samay312006/cad_project/docs/review/fig_serial_monitor.png

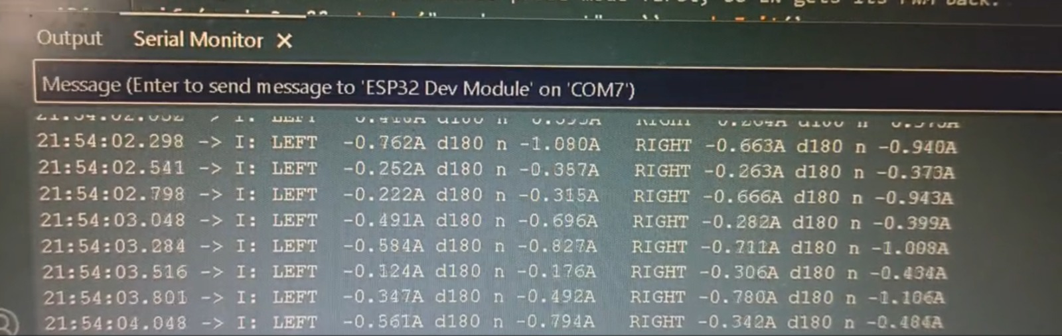
docs/review/fig_serial_monitor.png
