samay312006/cad_project/docs/review/fig_bench_photo.png

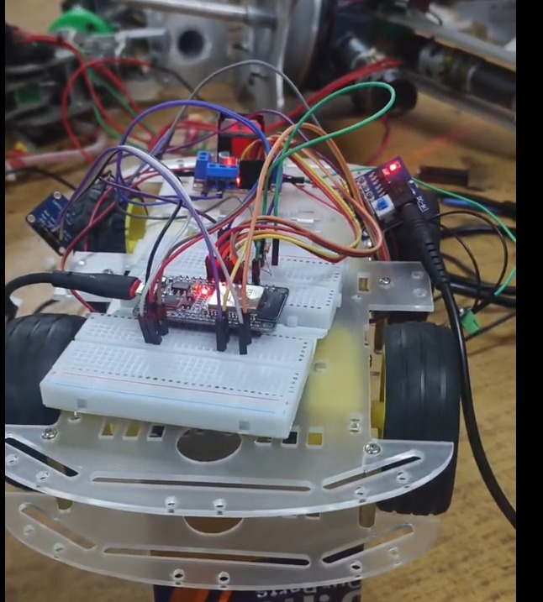
docs/review/fig_bench_photo.png
