samay312006/cad_project/UPDATES.md

# Updates & Blockers

Read this at the start of every session, both engineers. It's a pointer list, not a
discussion log — details belong in `spec.md`/`plan.md` or your own commits/PRs.

## Open blockers

| # | Blocker | Blocks | Owner to resolve | Opened |
|---|---|---|---|---|
| 3 | Single-point range sensor + servo BOM (`[TBD]` in spec) not chosen — sensor sample time and servo slew speed are unknown, so achievable scan rate/resolution is unknown | Both — embedded can't finalize driver/timing code; cloud/GUI can't set realistic SLAM Toolbox scan-rate expectations or Follow-me acceptance criteria (`spec.md` §8 Follow-me/SLAM rows are explicitly left open pending this) | Human (BOM decision) | 2026-08-27 |
| 6 | Incline-compensation telemetry fields (`spec.md` §6.1) — the approved design adds `boost_pct` (float, 0.0–0.5) and `compensating` (bool) to the telemetry message so the GUI can indicate when the ESP32 is boosting drive power. Design approved but **not yet written into §6.1**; fields do not exist on the wire yet | Cloud/GUI engineer — don't bind a dashboard to the current §6.1 shape without accounting for these two additive fields. Additive only, nothing renamed or removed | Embedded engineer (to land the §6.1 edit) | 2026-09-03 |
| 9 | **Partly done 2026-10-17 on the real EC2 link** (details in `HANDOFF.md` top note): connect, drive, telemetry, watchdog (fires 1.5 s after last received message; ~2.4-2.9 s end-to-end because link latency ~1 s), inbound-black-hole stop (~2 s, not 15 s), and broker-restart auto-reconnect (~2 s) all pass. **Still needs the human at the bench:** Wi-Fi drop + auto-reconnect, telemetry cross-check vs `drive_test.ino` under load, human-observed motor direction. Original text: New MQTT-based `embedded/web_drive/` firmware + `cloud/dashboard/` frontend (`docs/superpowers/plans/2026-10-04-cloud-web-dashboard.md`) is written and passes local-rehearsal checks against a Dockerized Mosquitto broker, but **has not been bench-tested on real ESP32 hardware** — same situation as the original web_drive bring-up tool (`UPDATES.md` #7's resolution). Needs: wheels-off-the-ground bring-up, watchdog-trip verification on a real link **including a mid-packet/partial-drive-message link drop specifically** (`mqtt_handler.h`'s `setSocketTimeout(1)` bounds but doesn't eliminate a `PubSubClient::loop()` blocking stall — confirm the watchdog still fires within ~2.5s, not the library's old 15s default), a check that the ESP32 core's default Wi-Fi auto-reconnect actually recovers the link without a manual reset, and telemetry cross-check against `drive_test.ino`'s known-good values (full checklist in the design doc's §8 and the plan's Task 4 Step 4). | Whoever's at the bench next — hardware bring-up isn't role-exclusive the way firmware authorship is (see `ONBOARDING.md` §1's physical-hardware note) | Whoever does the bench bring-up | 2026-10-06 |
| 10 | Dropping the phone bridge means the ESP32 itself (not the phone) now needs internet reachability for the full robot, and the ESP32 has no cellular radio in the current sensor list (`spec.md` §4, `ESP32 variant` still `[TBD]`) — outdoor/away-from-fixed-Wi-Fi operation needs either a carried Wi-Fi hotspot or a cellular-capable ESP32 variant/add-on, neither currently planned (`spec.md` §7 assumption 6, `plan.md` §2c.2). | Both — affects the embedded engineer's eventual ESP32-variant BOM choice and the cloud/GUI engineer's assumptions about field connectivity | Human (BOM/connectivity decision, same category as blocker #3) | 2026-10-06 |
| 11 | The MQTT-based redesign has no per-topic client arbitration — the old local-AP design allowed at most one WebSocket client at a time (`wsClientFd`); `robot/{id}/drive` now accepts publishes from any connected client with no "who's in control" concept, so two open dashboard tabs/devices would silently fight over the same topic. Not fixed by `docs/superpowers/plans/2026-10-04-cloud-web-dashboard.md` (out of its v1 scope, design D7) — flagging so it isn't a silent regression. | Cloud/GUI engineer, whenever multi-operator/multi-tab use becomes a real scenario (not v1) | Cloud/GUI engineer | 2026-10-06 |
| 12 | `plan.md` §2a's local-sim architecture (§2a.2/2a.3/2a.5/2a.6 — the Gazebo "simulated-phone" ROS2 node) still describes the old ESP32↔phone JSON-over-UDP contract and wasn't updated by `docs/superpowers/plans/2026-10-04-cloud-web-dashboard.md` (out of that plan's scope — it only touched `plan.md` §2c). Needs its own pass once SLAM/Nav2 sim work actually starts. | Cloud/GUI engineer (2a is cloud/GUI-owned sim work) | Cloud/GUI engineer | 2026-10-06 |
| 13 | `CLAUDE.md`, `ONBOARDING.md`, and the `CLAUDE.local.md` template in `ONBOARDING.md` still describe the cloud/GUI role as owning "the Android phone app (GUI + phone-side Wi-Fi client + phone-side MQTT client)" and the shared-contract line still says "the ESP32↔phone message schema and the phone↔EC2 MQTT topics" — both stale after blocker #8's resolution. Nobody's `CLAUDE.local.md` has been updated to mention `cloud/dashboard/` or who owns `embedded/web_drive/mqtt_handler.h` going forward. Not fixed here — these are shared project-instruction files and changing the stated role boundary is a human decision, not something either engineer's session should do unilaterally. | Both sessions read these at the start of every session — stale role text risks the next cloud/GUI session either building the cancelled Android app or being unsure whether it still owns `embedded/web_drive/mqtt_handler.h` | Human (role-boundary wording decision) | 2026-10-06 |
| 14 | `spec.md` §5's mode-transition table and §6.1's Fail-safe bullet both now mark "ESP32↔EC2 heartbeat loss → SAFE_HOLD" as `[TBD]` (see the note added under §5's table 2026-10-06) — the old design had two separate links with two separate fail-safe policies (ESP32↔Phone heartbeat loss → SAFE_HOLD; Phone↔EC2 loss → degrade-but-continue, NFR-6), and collapsing them into one ESP32↔EC2 hop left it undefined which policy a *total* link loss should trigger, versus NFR-6's narrower "stale plan" case. The `heartbeat` `cmd_type` itself has no defined rate/timeout either. | Embedded engineer — needs this resolved before building SAFE_HOLD/the mode state machine on the ESP32, since it changes what `mqtt_handler.h` needs to do beyond the drive watchdog | Embedded engineer (with cloud/GUI, since it also affects what the dashboard needs to show) | 2026-10-06 |
| 15 | **EC2 broker is up (2026-10-16)** in `ap-southeast-2`, account 687633314412 (profile `robot2`): `robot-broker-2` (`i-076e0f36edc586e82`, t3.small) at Elastic IP `52.65.238.172`; Mosquitto TLS 8883 (self-signed cert, IP SAN) + nginx 443 serving the dashboard with `/mqtt` WSS proxy; users `esp32` and `dashboard` (passwords only in the human's `~/.robot-broker-credentials`, not in git). Config in `cloud/ec2/`. SSH (22) is open to 0.0.0.0/0 at the human's request, key `~/.ssh/robot-broker-2.pem`. Dashboard `wss://` + login overlay is **done and deployed** (2026-10-16; https = login + `wss://host/mqtt`, plain http = local anonymous rehearsal unchanged). **ESP32 flashed 2026-10-17** and running the TLS firmware (pinned cert + `esp32` login). The TLS change is now **in the repo** (`embedded/web_drive/mqtt_handler.h`, `web_drive.ino`; one-off exception per `HANDOFF.md` §5, human-directed) — the embedded engineer owns these files again from here; credentials come from the gitignored `secrets.h` (template `secrets.h.example`). Bench results are in #9. **Open:** ~1 s link latency to Sydney (TCP connect ~0.43 s from the dev PC) — a Mumbai `ap-south-1` broker would likely help, needs the human's yes; $10/month budget alarm still needs an email from the human; old unused key pair `robot-broker` and SG `robot-broker-sg` remain (free) in Sydney. Formerly pending: the firmware TLS change (`mqtt_handler.h`: `WiFiClientSecure`, creds, trust the self-signed cert). Bench results/gotchas in `HANDOFF.md` (its 'no AWS resource exists' text is now stale) | ESP32 cannot reach the EC2 broker until the TLS change lands | Cloud/GUI (dashboard) / Embedded (firmware TLS) | 2026-10-13 |
| 16 | **Motors feel slow at full dashboard command.** Measured 2026-10-17 over the live link: a 255 command is applied as duty **131/255** (both sides, ~0.2-0.6 A, no load) because `drive_core.h` `dutyMaxCounts()` clamps to `V_MOTOR_MAX=5.5 V` using the *default, never-measured* `v0Drop=1.9 V`/`rTot=2.5` (motors rated 3-6 V on a 12.6 V L298N supply). Dashboard side already compensated (speed cap default 100%, `MIN_DUTY=70` floor in `mix.js`); the remaining limit is the firmware clamp, which cloud/GUI did not touch. Needs: run `drive_calib.ino` to measure the real drop, confirm motor voltage rating, decide whether to raise `V_MOTOR_MAX` (6.0 V rated max = ~143 duty, only ~9% more) or change motors/gearing | Embedded engineer (owns the clamp) / Human (motor rating, hardware) | Embedded engineer + Human | 2026-10-17 |
| 17 | **Human-directed changes 2026-10-17 (cloud/GUI session touched embedded files — logged here per CLAUDE.md):** (a) `embedded/web_drive/drive_core.h`: motor-voltage duty clamp **disabled** via `APPLY_MOTOR_VOLTAGE_CLAMP=false` (turns stalled at the clamped ~131/255) — with it off a full command puts ~10 V on 3-6 V motors, so the embedded engineer should decide the permanent policy (row #16); dashboard speed-cap slider removed. (b) New electromagnet support in `web_drive`: `magnet.h` (relay on **GPIO23** per the human — `drive_test.ino` and the team pin plan still say GPIO19, embedded engineer to reconcile), topic `robot/{id}/magnet` `{"on":bool}`, additive telemetry `magnet` field, state latched against watchdog/stop/link-loss — **new shared wire contract, `spec.md` §6.1 updated**. Not yet verified with a real relay/magnet attached | Embedded engineer: review/own these files going forward; dashboard binds to `magnet` in telemetry | Embedded engineer + Human | 2026-10-17 |

## Recently resolved

| # | Blocker | Resolution | Date |
|---|---|---|---|
| 5 | Current-sensor granularity (`spec.md` §4/§6.1) left `fl/fr/rl/rr` in the telemetry schema ambiguous about whether all 4 were independent readings | Resolved to 2x INA219, one per drive channel (left/right side, matching the skid-steer chassis) — `fl`==`rl` (left side) and `fr`==`rr` (right side) always report the same value. `spec.md` §4 (current sensor row) and §6.1 (telemetry example) updated with an explicit note. **Correction 2026-08-29**: an earlier version of this note/edit had the pairing backwards (`fl`==`fr`, front/rear) — fixed to the correct side-based pairing before it reached the diagram or any GUI work. If any GUI/dashboard work already assumed `fl`==`fr`, rebuild against the corrected schema. | 2026-08-29 |
| 1 | Wireless-link + sensor architecture wasn't yet applied to the docs | Applied to `spec.md` (§3, §4, §5, §6.1, §6.2, §6.3, §7, §8, §9), `plan.md` (2a.2, 2a.3, 2a.5, 2a.6, 2b.2, 2c.3, 2c.5), and both `overview_*.md` files. Both engineers can now code against the new interface. | 2026-08-27 |
| 2 | Packet framing for the ESP32↔phone Wi-Fi link wasn't defined | Defined in `spec.md` §6.1: UDP, one JSON message per datagram, `~1200 byte` MTU headroom, new `scan_sample` message type alongside existing telemetry/command messages. Still `[ASSUMPTION]`-tagged, not yet bench-verified, but the cloud/GUI engineer can build the phone-side client against it now. | 2026-08-27 |
| 4 | MQTT broker TLS/auth credential format for EC2 (`plan.md` 2b.3) not yet defined | Defined and live 2026-10-17: Mosquitto on 8883 with TLS (self-signed cert, CN/SAN = Elastic IP, pinned by the ESP32), username/password auth, two users `esp32` and `dashboard`, `/etc/mosquitto/acl` gives both `readwrite robot/#` (coarse; tighten per-topic later). Config in `cloud/ec2/`. | 2026-10-17 |
| 8 | Architecture change: `spec.md` §6.1/§6.2 (ESP32↔Phone↔EC2 two-hop) replaced by direct ESP32↔EC2 MQTT/TLS; phone-bridge role and the planned Android app are cancelled, replaced by a browser dashboard hosted on EC2. | User approved all of design decisions D1–D7 on 2026-10-04 (`docs/superpowers/specs/2026-10-04-cloud-web-dashboard-design.md`). Implemented locally only (no AWS resource created) per `docs/superpowers/plans/2026-10-04-cloud-web-dashboard.md`: `embedded/web_drive/` ported to Wi-Fi-station+MQTT (this session, explicit one-off exception — see that plan's role-boundary note), `cloud/dashboard/` is the new MQTT-over-WebSocket frontend, `cloud/docker-compose.yml` is the local Mosquitto rehearsal stack. `spec.md`, `overview_cloud.md`, `overview_controls.md`, and `plan.md` §2c updated to match. | 2026-10-06 |

## How to use this file

- Add a row the moment your work creates a dependency the other engineer needs to know
  about — don't wait for them to ask.
- When a blocker clears, move it to "Recently resolved" with a one-line note on how, and
  the date.
- Keep entries short. If it needs more than 2-3 sentences, put the detail in `spec.md` or
  a PR description and link to it here.
