samay312006/cad_project/docs/review/fig_current_plot.png

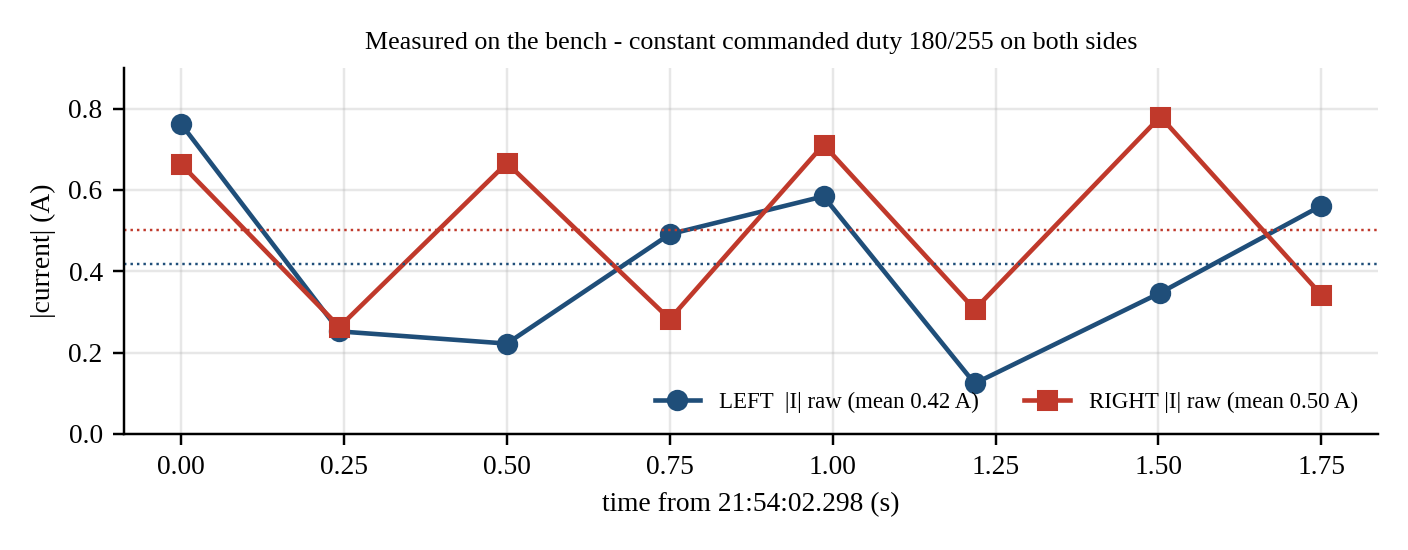
docs/review/fig_current_plot.png
