samay312006/cad_project/docs/review/fig_dash_login.png

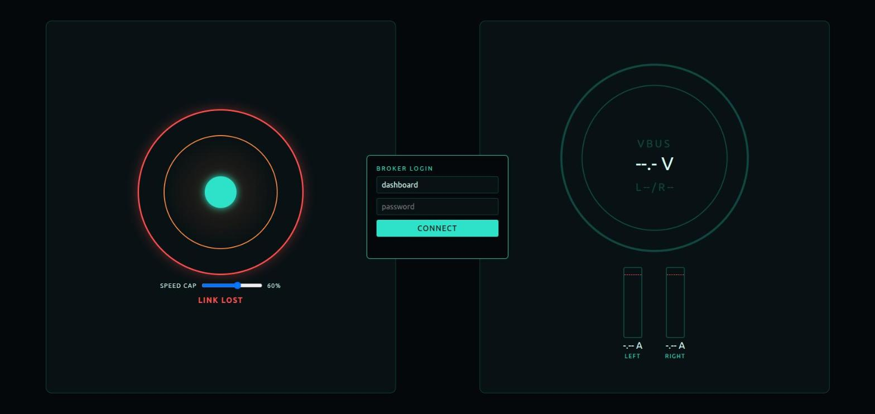
docs/review/fig_dash_login.png
