samay312006/cad_project/docs/review/fig_phone_live.png

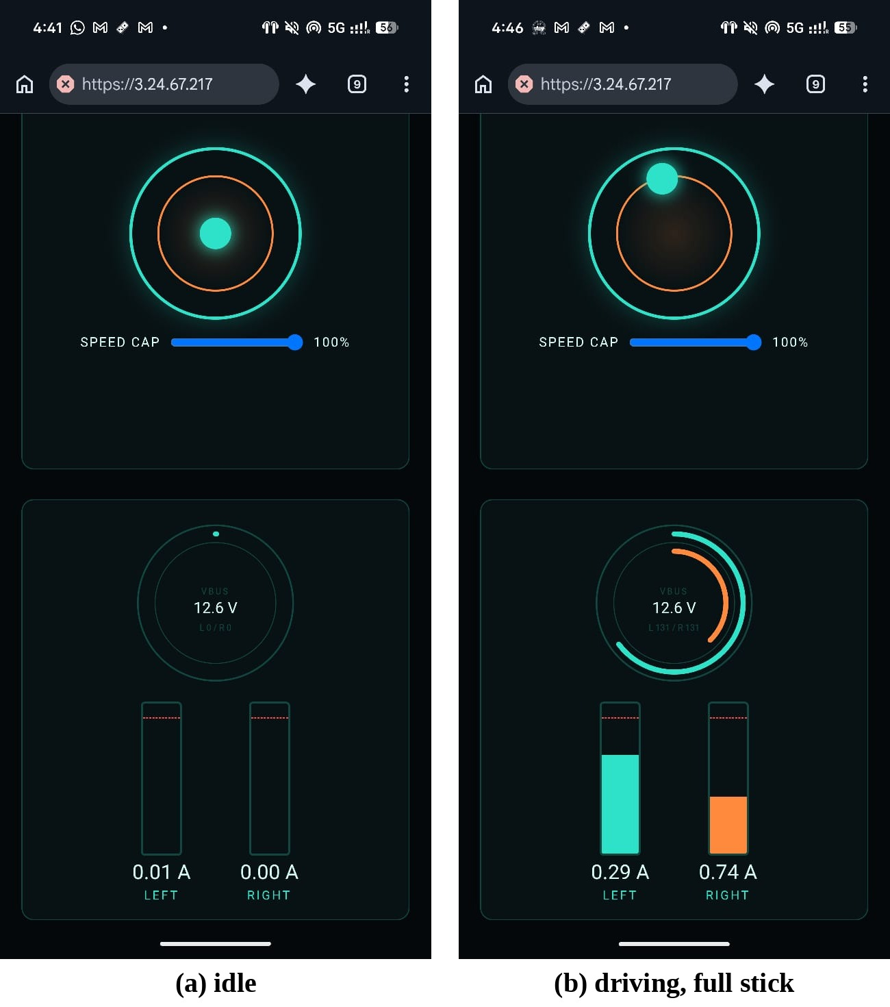
docs/review/fig_phone_live.png
