samay312006/cad_project/docs/review/fig_timings.png

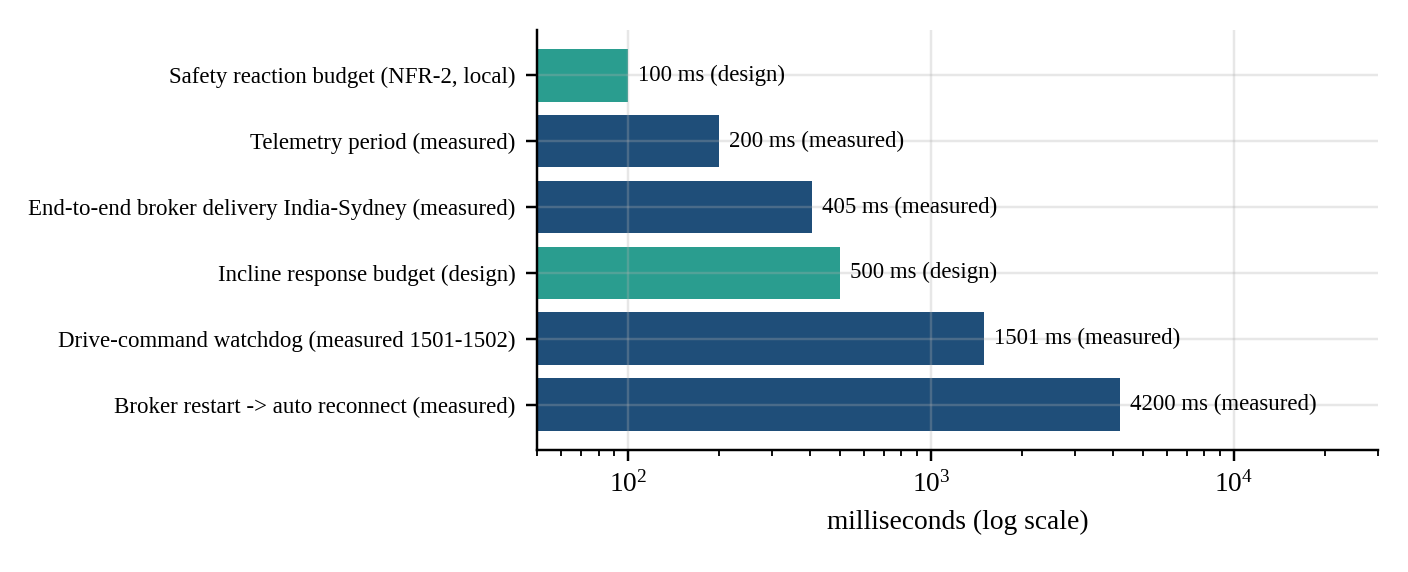
docs/review/fig_timings.png
