samay312006/cad_project/docs/review/fig_watchdog_plot.png

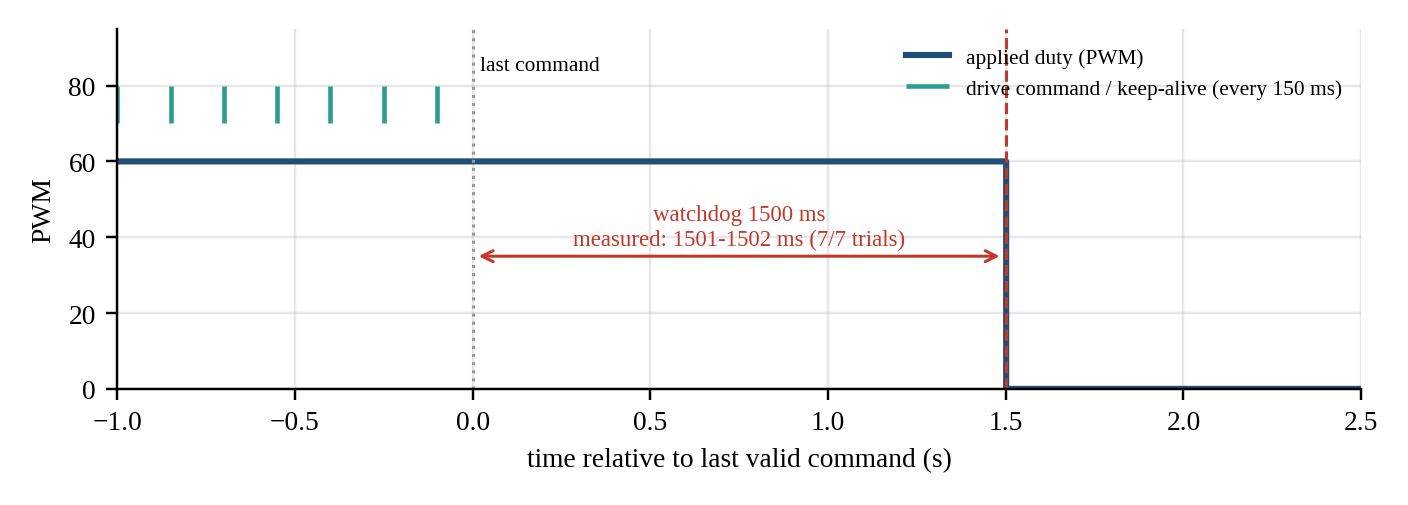
docs/review/fig_watchdog_plot.png
