samay312006/cad_project/docs/review/pin_actuators.png

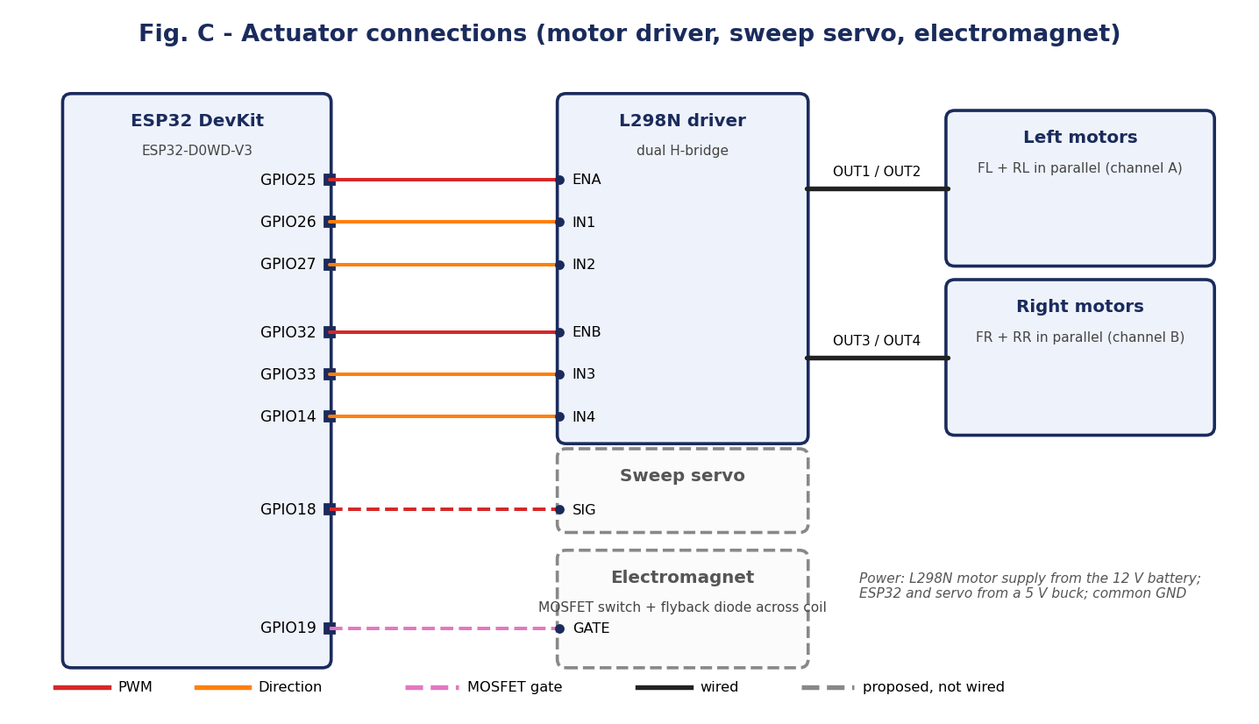
docs/review/pin_actuators.png
