samay312006/cad_project/docs/review/pin_gps.png

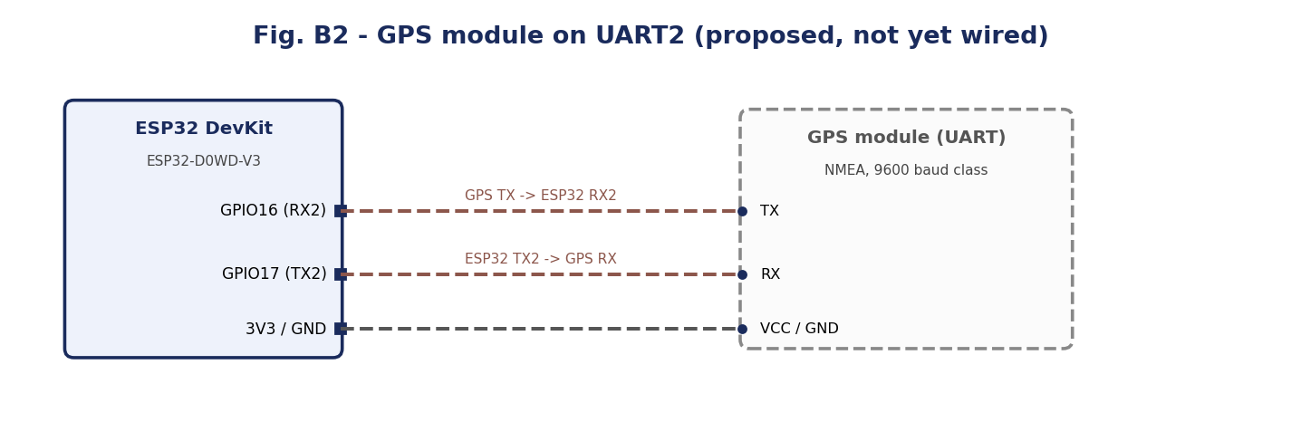
docs/review/pin_gps.png
