samay312006/cad_project/docs/review/pin_sensors_i2c.png

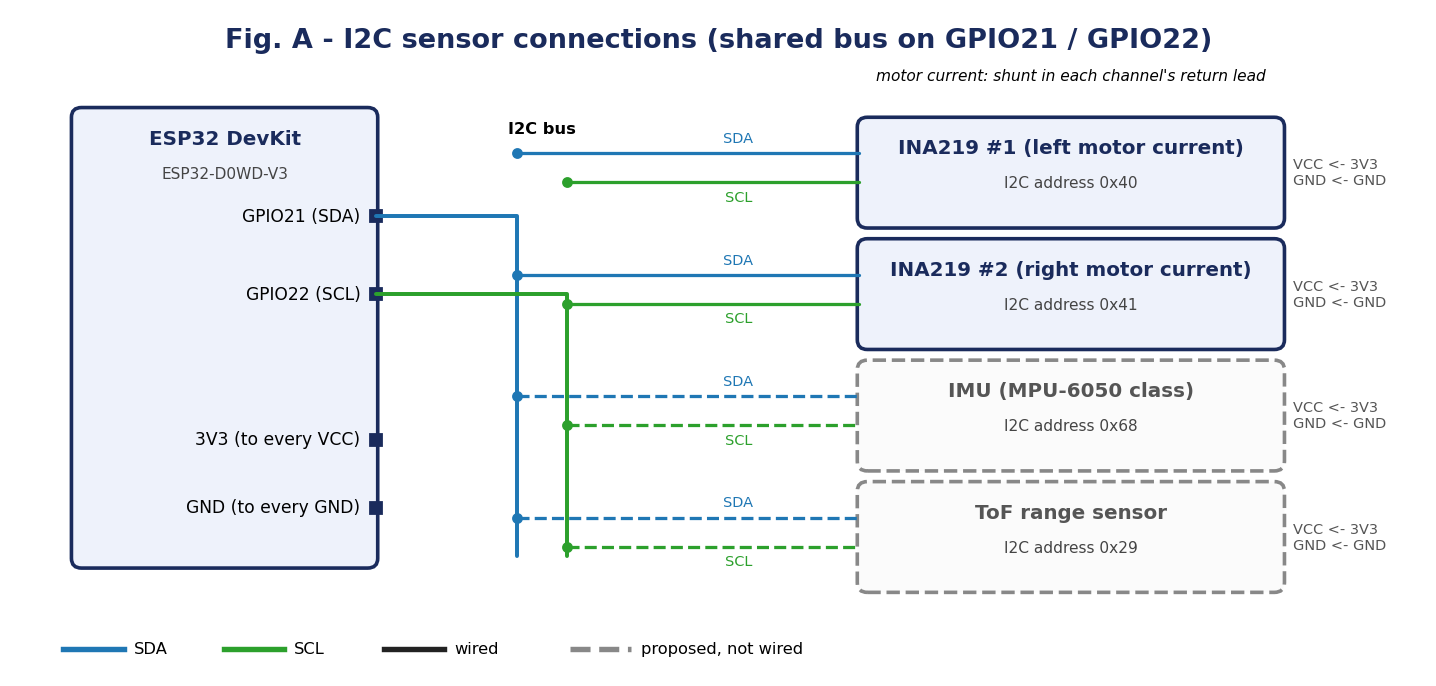
docs/review/pin_sensors_i2c.png
