samay312006/cad_project/docs/review/pin_vbus_divider.png

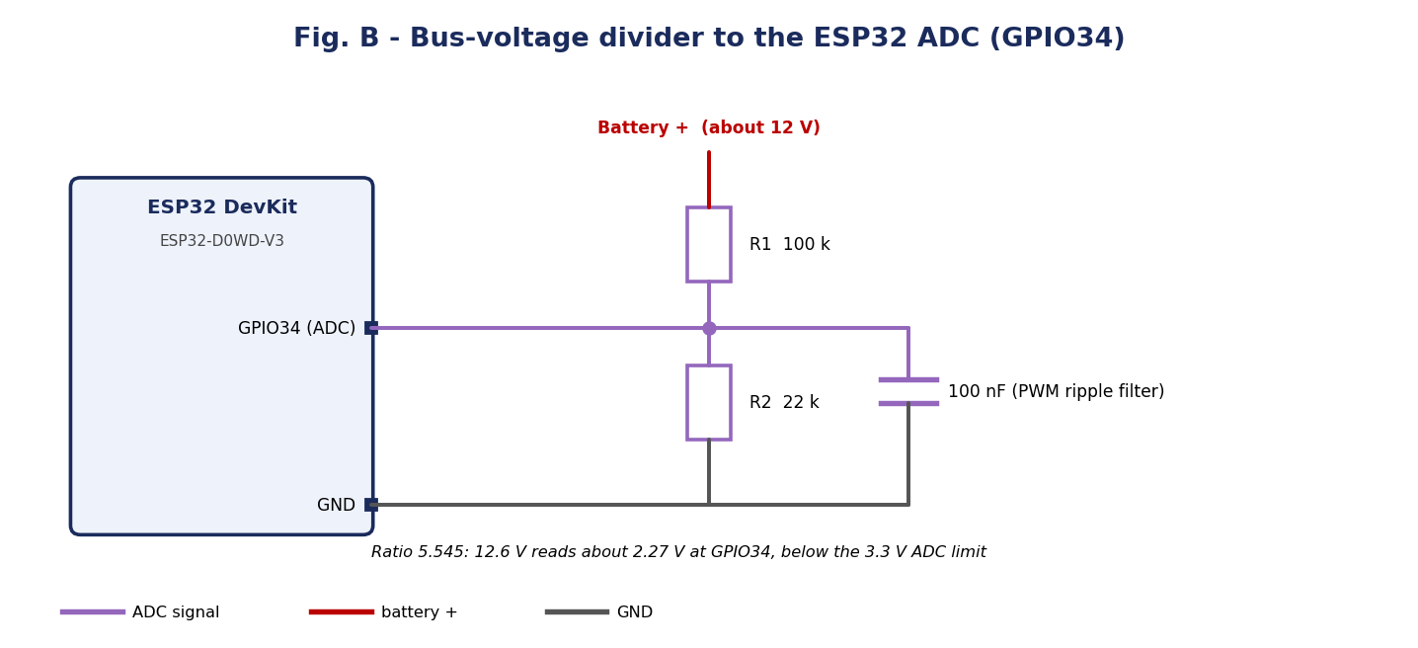
docs/review/pin_vbus_divider.png
