samay312006/cad_project/docs/review/fig_wiring.png

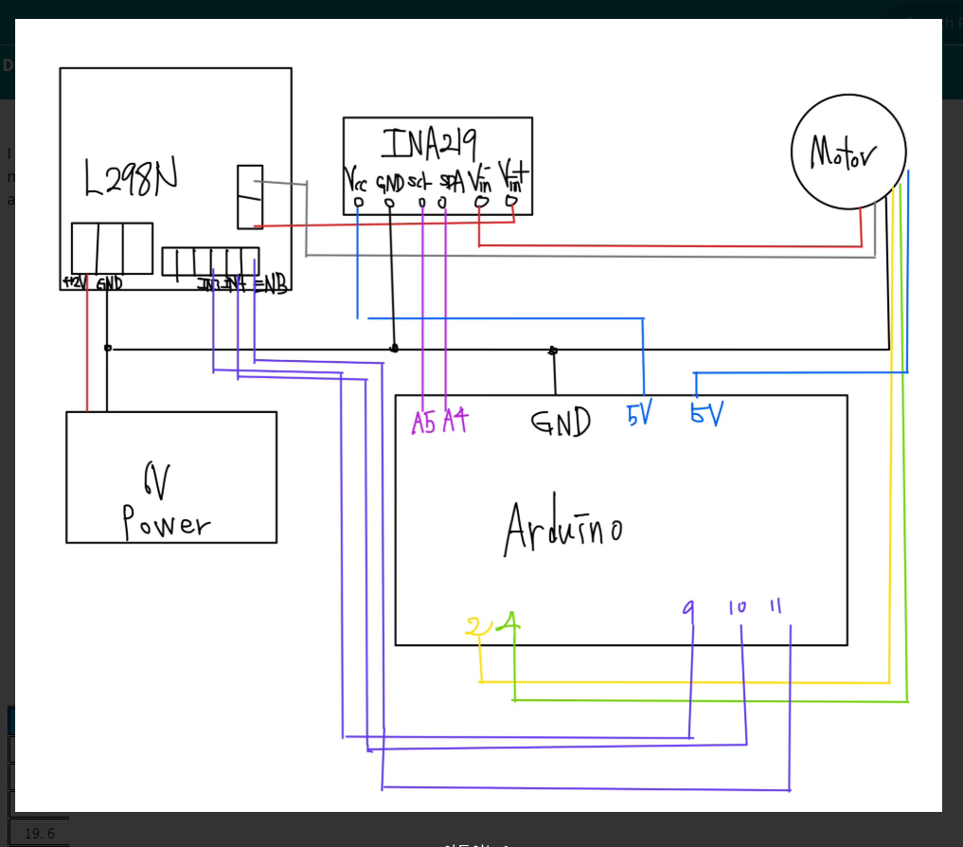
docs/review/fig_wiring.png
