samay312006/cad_project/(commit log)

2026-07-29 Add spec, plan, and dual-audience overview docs for robot+cloud control project
    Covers functional/non-functional requirements, mode state machine, interface
    contracts, and sensor BOM (spec.md); local-first sim environment, AWS setup,
    and integration phasing with per-phase edge cases (plan.md); and
    controls-heavy vs cloud-heavy project overviews sharing one fact spine.
2026-08-29 Set up shared project docs and lock in embedded-side wiring decisions
    Adds the shared CLAUDE.md role-split config, ONBOARDING.md, and the
    UPDATES.md cross-team blocker tracker, plus a .gitignore for the
    per-engineer CLAUDE.local.md. Updates spec.md's current-sensor BOM row
    and telemetry schema note to reflect 2x INA219 per drive channel
    (left/right side, matching the skid-steer chassis), including a fix to
    the fl/rl vs fr/rr pairing so it matches the actual left/right split.
2026-09-01 feat:esp32 code
2026-09-03 Add approved design for load-inference incline compensation (FR-6)
    Back-EMF speed-hold PI regulating on V_bemf rather than omega, with the
    two INA219 channels as load detector, stall gate and current ceiling.
    Creates the portable control core and HAL boundary plan.md 2a.3 requires.
    Records two findings from bench hardware:
    - The current-error loop drawn in overview_controls.md section 2 does not
    close. Steady-state current is set by load torque, not duty, so the
    error never returns to zero and the integrator winds up to saturation.
    Section 9 of the design documents the correction.
    - The FAM1029 motors are rated 3-6 V and the L298N is fed 12 V, so the
    bench default of speed=180 run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
2026-09-03 Add implementation plan for incline compensation
    Fourteen tasks: bench duty clamp, calibration, native test harness, five
    control modules built test-first, the simulated HAL, the eight scenario
    gates from the design, the ESP32 HAL, firmware integration, and the doc
    updates that resolve four spec.md TBDs.
    Claude-Session: https://claude.ai/code/session_01Sj3XL3B5zckZWScVSijW6H
2026-09-03 Add drive_calib sketch for measuring motor constants
    Separate sketch so drive_test stays the known-good bench tool. Measures
    only; never runs a control loop.
    L sweeps five duty points at locked rotor and least-squares fits
    V_bus*duty = V0 + I*R_tot. It fits both raw and duty-normalized current
    and reports the residual for each, because whether motor current keeps
    circulating through the return-lead shunt during PWM off-time depends on
    the freewheel path and is not safe to assume.
    k drives eight duty points on flat ground and emits a ready-to-paste
    calibration.h, warning if back-EMF fails to rise monotonically with duty.
    Carries the same duty clamp as drive_test, inside pwmWrite(), since t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
    [drive_calib.ino]
2026-09-03 Fold fit.h back into drive_calib.ino
    Return results through pointers instead of a struct. Arduino generates
    prototypes above the sketch body, so a custom return type is referenced
    before it is declared; built-in types avoid that without a second file.
    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
    [drive_calib.ino]
2026-09-03 Fix drive_calib sampling, duty range and table floor
    INA219 default conversion is 532 us against a 1000 us PWM period, so each
    reading caught a random slice of the on/off cycle rather than averaging
    over it. Bench data showed raw current falling as applied voltage rose,
    which a locked motor cannot do, and the line fits returned a negative
    resistance. Config register now selects 128-sample averaging (~68 ms per
    reading, ~68 PWM cycles) and sample gaps exceed the conversion time.
    The sweep also now rejects non-monotonic current instead of fitting it,
    and reports whether V_bus came from the divider or was hand-entered.
    Flat-ground table starts at duty 0.28 rather than 0.20: below ~0.235 the
    b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
    [drive_calib.ino, drive_test.ino]
2026-09-03 Add approved design for web-based drive/telemetry GUI (bring-up tool)
    Landscape browser GUI served from the ESP32 (Wi-Fi AP + WebSocket +
    LittleFS), reusing drive_test.ino's motor/current logic. Adds a duty
    clamp (drive_test.ino currently lacks one, per the incline-compensation
    design's flagged risk) and a command watchdog for wireless safety.
    Claude-Session: https://claude.ai/code/session_01SDv4DVyCn9WQBY4eRA4EHp
2026-09-03 Add web_drive drive_core.h (motor drive + duty clamp)
2026-09-03 Fix ws_handler.h review findings: close-frame, oversized frames, strtol, NaN
    Four review-confirmed bugs in ws_handler.h (Task 2), all self-contained
    within this file:
    1. Zero-payload CLOSE frames were dead code: the len==0 early return fired
    before pkt.type was ever checked, so a legal 0-byte close frame never
    cleared wsClientFd or called stopAll(). Now pkt.type is checked for
    HTTPD_WS_TYPE_CLOSE right after the header-only first recv call, before
    the len==0 return.
    2. Oversized frames were truncated-read without draining the rest of the
    frame from the socket, risking WS desync. Bumped the stack buffer to
    512 bytes (matches the file-serving buffer size elsewhere in this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
    [ws_handler.h]
2026-09-03 Best-effort drain of WS frame on malloc failure in ws_handler.h
    Round-2 fix: when malloc() for the oversized-frame receive buffer fails,
    wsHandler() previously returned ESP_ERR_NO_MEM immediately without ever
    calling httpd_ws_recv_frame() again, so zero bytes of the frame were
    drained from the socket. Add wsDrainBestEffort(), which reuses the
    existing 512-byte static buffer to make a bounded (max 8 iterations)
    best-effort attempt to read and discard the frame's payload before
    returning the same error. This does not guarantee full drain (ESP-IDF's
    chunked-read semantics for a single WS frame aren't verifiable without
    hardware here) but is strictly better than the prior zero-attempt path.
    The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
    [ws_handler.h]
2026-09-03 Add web_drive.ino (Wi-Fi AP, mDNS, server wiring)
2026-09-03 Fix keepalive not re-armed on WebSocket reconnect while dragging
    When the WebSocket reconnects while the user is still holding the joystick
    (dragging === true but no recent pointermove events), the onopen handler now
    checks if dragging is active and calls startKeepalive() to resume periodic
    drive messages immediately. This prevents the ESP32's 400ms command watchdog
    from timing out before the next pointer movement event.
    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
2026-09-04 Fix duty telemetry, watchdog race, and dead code in web_drive firmware
    Final whole-branch review fixes for the ESP32-side of web_drive:
    - drive_core.h: pwmWrite() now returns the actually-applied (clamped)
    duty so setSide() can record a signed, clamped lastDuty[] instead of
    the raw unclamped, unsigned request. Telemetry now shows the real
    duty and correct direction instead of an unclamped magnitude that
    hid both the clamp and the sign.
    - drive_core.h: documented the dropped invert field's workaround next
    to sides[].
    - ws_handler.h: record lastDriveMsgMs before calling drive(), not
    after, closing a race with the loop-task watchdog that could
    immediately undo a just-applied comm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
    [drive_core.h, web_drive.ino, ws_handler.h]
2026-09-04 Fix battery label clipping, arc init flash, and reconnect race in GUI
    Final whole-branch review fixes for the web_drive frontend:
    - style.css/index.html: #batteryLabel was clipped by
    .battery-gauge's overflow:hidden despite being absolutely positioned
    below it. Split .battery-gauge into an outer flex column (unclipped)
    and a new .battery-gauge-well inner wrapper that keeps the
    overflow:hidden clipping scoped to just the fill bar, so the label
    renders normally below the gauge.
    - app.js: initialize both current arcs to 0% on load instead of
    leaving stroke-dasharray unset, which rendered as full circles
    (looking like max current) until the first telemetry message.
    - app.js: conne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
2026-10-04 Add design: cloud-hosted drive dashboard, ESP32 direct to EC2 via MQTT
    Replaces the planned Android-app/phone-bridge remote-control path with a
    browser dashboard hosted on EC2, reached from any phone over the internet.
    ESP32 becomes a Wi-Fi station and MQTT/TLS client directly to the
    already-planned broker instead of hosting its own AP. No AWS resource
    created yet; design pending user review. Flags the cross-team impact on
    spec.md §6.1/§6.2 in UPDATES.md since this would obsolete the embedded
    engineer's current ESP32↔Phone interface assumptions.
2026-10-06 Add implementation plan for cloud-hosted drive dashboard (ESP32-EC2 MQTT)
    Claude-Session: https://claude.ai/code/session_01SroDirYUSboxFuc7dNuQxB
2026-10-06 Port ESP32 web_drive firmware from local-AP+WebSocket to Wi-Fi-station+MQTT
    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
2026-10-06 Rewrite spec.md for ESP32-EC2-direct architecture, retiring the phone bridge
    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
2026-10-06 Sync overview_cloud.md, overview_controls.md, and plan.md §2c to the ESP32-EC2-direct architecture
    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
2026-10-06 Fix review findings: telemetry staleness detection and type validation
    Final review on the cloud-web-dashboard-mqtt branch found two Important
    gaps: the dashboard had no way to tell "broker reachable" apart from
    "robot reachable" (a dropped ESP32 looked identical to a live one once
    telemetry stopped updating), and parseTelemetryMessage checked for field
    presence but not type, so a malformed-but-present field (string/null/
    object) would reach renderTelemetry() and throw or render garbage.
    Adds isTelemetryStale() (pure, tested) and wires a periodic check into
    app.js that flips the status ring to "stopped"/"ROBOT OFFLINE" when no
    telemetry has arrived within 1s, independent of the MQTT broker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
2026-10-06 Fix review finding: bound PubSubClient's blocking read against the watchdog
    mqttClient.loop() can block inside a partial-packet read for up to
    PubSubClient's default 15s socket timeout, during which
    mqttWatchdogCheck() doesn't run - long enough to blow well past the
    1500ms watchdog window if the link dies mid-packet. setSocketTimeout(1)
    bounds that stall to ~1s; setKeepAlive(5) also speeds up detecting a
    half-dead TCP connection. Documented as a bound, not a guarantee - the
    fully robust fix is a separate watchdog task, flagged in UPDATES.md
    blocker #9's bench checklist alongside this scenario.
    Claude-Session: https://claude.ai/code/ses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
2026-10-06 Fix review findings: EC2 firewall port gap and SAFE_HOLD/heartbeat ambiguity
    Final review found two doc-level contradictions introduced by the
    §6.1/§6.2 merge:
    1. The design doc, overview_cloud.md, and plan.md disagreed on EC2's
    security group - some said only 443, some only "the MQTT port" with
    no 443 at all. Neither alone is correct: the ESP32's PubSubClient
    speaks raw TCP MQTT and can't go through nginx's WSS proxy on 443, so
    it needs its own port (8883) alongside 443 (dashboard) and 22 (SSH).
    All three docs now agree.
    2. spec.md §5's mode-transition table claimed "heartbeat loss (ESP32↔EC2)
    -> SAFE_HOLD", which contradicts NFR-6/§8's "continue on last plan
    wh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
2026-10-17 Dashboard: current bars, min-duty floor, nginx /mqtt fix; web_drive revert; docs
    - cloud/dashboard: replace VBUS dial/battery with left/right current bars;
    default speed cap 100% and MIN_DUTY=70 floor in mix.js (tests added)
    - cloud/ec2/nginx-robot.conf: match /mqtt exactly (prefix match was 502ing
    /mqtt_topics.js)
    - embedded/web_drive: drop the WiFi.setSleep(false) experiment (no effect)
    - HANDOFF.md/UPDATES.md: live EC2 broker state, bench results, row #16
    (firmware duty clamp limits motor speed)
2026-10-17 Back up working firmware before adding the electromagnet relay
    Snapshot of drive_test, drive_calib and web_drive (secrets.h excluded)
    in embedded/backup/2026-10-17/; the pre-change commit is also tagged
    backup-2026-10-17.
2026-10-17 drive_test: electromagnet on/off via relay on GPIO23 (g = grab, r = release)
    Relay NO contact switches the magnet supply; no PWM. Pin is latched to
    the OFF level before becoming an output so the magnet never pulses on
    at boot, and stop/self-test/probe leave the magnet as-is so a stop never
    drops a carried box (spec.md §5 latched-magnet rule). RELAY_ACTIVE_HIGH
    selects the module's trigger polarity.
2026-10-17 drive_test: move electromagnet relay to GPIO19 per the team pin plan
    docs/review/pin_actuators.png assigns the electromagnet to GPIO19; the
    switch element is now a relay module (NO contact) instead of a MOSFET.
2026-10-17 web_drive: electromagnet topic, uncapped drive PWM; dashboard magnet button, no speed cap
    - embedded/web_drive: magnet.h (GPIO19 relay, latched, boots OFF),
    robot/{id}/magnet {"on":bool}, additive telemetry "magnet" field;
    motor-voltage duty clamp disabled via APPLY_MOTOR_VOLTAGE_CLAMP=false
    (human-directed; see UPDATES #16/#17)
    - cloud/dashboard: ON/OFF electromagnet button driven by robot-reported
    state; speed-cap slider removed; tests extended
    - spec.md 6.1 + UPDATES.md: new topic/field, human-directed embedded edits
